petegaggs/DOMS-mini-synth/README.md

# DOMS-mini-synth
An arduino controlled mini-synth with MIDI input, AS3394E main voice, AS3340 2nd oscillator
