petegaggs/DOMS-mini-synth/DOMS_SYNTH_BOM_2.1.xlsx

Sheet: Main Board Parts
Description | Designator | Footprint | Quantity | Manufacturer Part | Manufacturer | Supplier | Supplier Part
DOMS synth
Rev 2.1
Bill of materials
Main board parts
Semiconductors
ATMEGA328P-PU | U1 | DIP-28_300MIL | 1 | ATMEGA328P-PU | ATMEL
IC 6N139 Opto Isolator | U2 | DIP-8 | 1 | 6N139M | FAIRCHILD
Diode 1N4148 | D1,D3,D4,D6,D7 | DO-35 | 5
Diode 1N4004 | D2,D5 | DO-41 | 2
IC Voltage Controlled Oscillator Alfa AS3340 | U16 | DIP-16 | 1 | AS3340 | Alfa Rpar | Soundtronics | 7212-591
IC uP controllable synthesizer voice AS3394E | U6 | DIP-24 | 1 | AS3394E | Alfa Rpar | Soundtronics | 7212-594
Adjustable Precision shunt regulator 1% TL431ACLP | U10 | TO-92 | 1 | TL431ACLP | TI
IC 12-bit dual SPI DAC MCP4822-E/P | U4 | DIP-8 | 1 | MCP4822-E/P | Microchip | Digi-Key | MCP4822-E/P-ND
IC Voltage regulator positive adjustable TO-220 1.5A LM317T | U5,U3,U22 | TO-220-3 | 3 | LM317T/NOPB | TI | Digi-key | LM317TNS/NOPB-ND
IC Voltage regulator negative adjustable TO-220 1.5A LM337T | U7,U11 | TO-220-3 | 2 | LM337T/NOPB | TI | Digi-key | LM337TNS/NOPB-ND
IC Quad Op amp LM324N DIP-14 | U13,U12,U9,U14,U8 | PDIP-14 | 5 | LM324N/NOPB | TI
Resistors
Resistor Metal Film 1/4W 1% 100R | R40 | AXIAL-0.4 | 1
Resistor Metal Film 1/4W 1% 220R | R83 | AXIAL-0.4 | 1
Resistor Metal Film 1/4W 1% 100R | R40 | AXIAL-0.4 | 1
Resistor Metal Film 1/4W 1% 470R | R55,R60 | AXIAL-0.4 | 2
Resistor Metal Film 1/4W 1% 510R | R42 | AXIAL-0.4 | 1
Resistor Metal Film 1/4W 1% 560R | R77,R79 | AXIAL-0.4 | 2
Resistor Metal Film 1/4W 1% 820R | R9 | AXIAL-0.4 | 1
Resistor Metal Film 1/4W 1% 1K | R63,R82,R73 | AXIAL-0.4 | 3
Resistor Metal Film 1/4W 1% 1K8 | R56 | AXIAL-0.4 | 1
Resistor Metal Film 1/4W 1% 3K | R81,R76 | AXIAL-0.4 | 2
Resistor Metal Film 1/4W 1% 3K3 | R8 | AXIAL-0.4 | 1
Resistor Metal Film 1/4W 1% 4K7 | R7,R78,R80 | AXIAL-0.4 | 3
Resistor Metal Film 1/4W 1% 5K6 | R43 | AXIAL-0.4 | 1
Resistor Metal Film 1/4W 1% 10K | R46,R47,R48,R53,R64,R71,R1,R11,R39,R70 | AXIAL-0.4 | 10
Resistor Metal Film 1/4W 1% 15K | R50,R51 | AXIAL-0.4 | 2
Resistor Metal Film 1/4W 1% 18K | R22 | AXIAL-0.4 | 1
Resistor Metal Film 1/4W 1% 20K | R26,R27,R44 | AXIAL-0.4 | 3
Resistor Metal Film 1/4W 1% 24K | R41,R10 | AXIAL-0.4 | 2
Resistor Metal Film 1/4W 1% 30K | R49,R52 | AXIAL-0.4 | 2
Resistor Metal Film 1/4W 1% 33K | R21 | AXIAL-0.4 | 1
Resistor Metal Film 1/4W 1% 47K | R36,R37,R72 | AXIAL-0.4 | 3
Resistor Metal Film 1/4W 1% 51K | R57,R62 | AXIAL-0.4 | 2
Resistor Metal Film 1/4W 1% 56K | R61 | AXIAL-0.4 | 1
Resistor Metal Film 1/4W 1% 62K | R15,R16 | AXIAL-0.4 | 2
Resistor Metal Film 1/4W 1% 68K | R65,R6 | AXIAL-0.4 | 2
Resistor Metal Film 1/4W 1% 75K | R4 | AXIAL-0.4 | 1
Resistor Metal Film 1/4W 1% 82K | R28 | AXIAL-0.4 | 1
Resistor Metal Film 1/4W 1% 100K | R59,R38,R69,R75,R23,R29,R30,R13,R17,R18,R32,R33,R12 | AXIAL-0.4 | 13
Resistor Metal Film 1/4W 1% 130K | R3 | AXIAL-0.4 | 1
Resistor Metal Film 1/4W 1% 150K | R66,R19,R20,R31 | AXIAL-0.4 | 4
Resistor Metal Film 1/4W 1% 180K | R68 | AXIAL-0.4 | 1
Resistor Metal Film 1/4W 1% 240K | R35,R67,R5 | AXIAL-0.4 | 3
Resistor Metal Film 1/4W 1% 270K | R34 | AXIAL-0.4 | 1
Resistor Metal Film 1/4W 1% 300K | R58 | AXIAL-0.4 | 1
Resistor Metal Film 1/4W 1% 330K | R24,R14 | AXIAL-0.4 | 2
Resistor Metal Film 1/4W 1% 1M | R45,R54,R74,R25 | AXIAL-0.4 | 4
Capacitors
Capacitor ceramic 22pF 50V NPO 10% | C1,C2 | RAD-0.1 | 2
Capacitor Ceramic NPO 50V 5% 5mm 150pF | C55 | CAP-TH_L5.0 | 1
Capacitor multilayer ceramic 50V 10% 560p | C38 | 4.5MM X 7.2MM | 1 |  |  | Tayda | A-1365
Capacitor Polyester WIMA FKS2 100v 5% 1nF | C29,C46 | 4.5MM X 7.2MM | 2 | FKS2D011001A00JSSD | WIMA | Tayda | A-1531
Capacitor Polyester 100V 5% 1.5nF | C54 | CAP-TH_L5.0 | 1 |  |  | Soundtronics | 7212-778
Capacitor Polyester WIMA FKS2 100v 5% 2.2nF | C30,C33 | 4.5MM X 7.2MM | 2 | FKS2D012201A00JSSD | WIMA | Tayda | A-935
Capacitor Ceramic NPO 50V 5% 5n6 | C31 | CAP-TH_L5.0-W2.5-P5.08-D0.7 | 1 | C320C104K5R5TA7303 | KEMET | LCSC | C236029
Capacitor Ceramic radial X7R 50V 10% 10nF | C47,C49,C50,C56,C53 | CAP-TH_L5.0 | 5 |  |  | Soundtronics | 7212-746
Capacitor Ceramic radial X7R 50V 10% 15nF | C51,C52 | CAP-TH_L5.0 | 2 |  |  | Soundtronics | 2069-066
Capaictor Polyester WIMA MKS2 100V 5% 33nF | C35,C36,C37 | 4.5MM X 7.2MM | 3 | MKS2D023301A00JSSD | WIMA | Tayda | A-4172
Capacitor Ceramic radial X7R 50V 10% 100nF | C10,C44,C45,C48,C41,C42,C27,C28,C32,C34,C3,C4,C5,C12,C11,C21,C23,C24,C22,C26,C14,C16,C17,C19,C20,C9,C57,C58,C59,C60 | CAP-TH_L5.0 | 30 |  |  | Tayda | A-214
Capacitor Electrolytic Non-Polar 4.7uF 50V 5x11 | C43 | CAP-5*11 | 1 |  |  | Soundtronics | 7213-310
Capacitor Electrolytic 100uF 16V 85 degree 6.3x11 | C15,C7,C25,C13,C18 | CAP-TH_D0.7-L6.3-H7-PITCH2.5 | 5
Capacitor Electrolytic 4700uF 20% 25V 16x26mm | C8,C6 | CAP-D18.0XF7.5 | 2
Crystals
Crystal HC-49 16.000MHz low profile | Y1 | HC49US | 1
Connectors
Header Male 0.1” pitch single row 2 way | P1 |  | 1
Header Male 0.1” pitch single row 6 way | P4 |  | 1
Switches
Miniature Toggle Switch SPDT ON/ON | S1,S4,S3 | SWITCH_TOGGLE_SPDT | 3 |  |  | Soundtronics | 7212-250
Miniature Toggle Switch SPDT ON/OFF/ON | S2 | SWITCH_TOGGLE_SPDT | 1 |  |  | Soundtronics | 7212-250
Potentiometers
POT 9mm PCB Mount 100K Linear | VR15,VR11,VR12,VR4,VR7,VR8,VR9,VR16,VR17,VR18,VR19,VR3,VR5,VR6,VR10 | POT-VERT-9MM | 15 | None |  | Soundtronics | 7300-785
Trimmer POT 25 turns 3296W 10K 10 % | VR13,VR1 | TRIMPOT 3 POLE | 2 | 3296W-1-103LF | Bourns | Soundtronics | 7212-857
Trimmer POT 25 turns 3296W 20K 10 % | VR14,VR2 | TRIMPOT 3 POLE | 2 | 3296W-1-203LF | Bourns | Soundtronics | 7212-858

Sheet: Other parts
DOMS synth
Rev 2.0
Bill of materials
Other parts
Description | Function | Quantity
DC Power Jack 2.1mm Panel Mount Bulkhead | Power in AC12V | 1
Knobs | for pots | 14
5-Pin DIN Socket, panel mount | MIDI in | 1
6.35mm 1/4" Mono Chassis Socket | Audio out | 1
Case |  | 1
Aluminium panel 200mm x 150mm x 1.5mm thickness |  | 1
