petegaggs/DOMS-mini-synth/DOMS schematic rev2.1.pdf

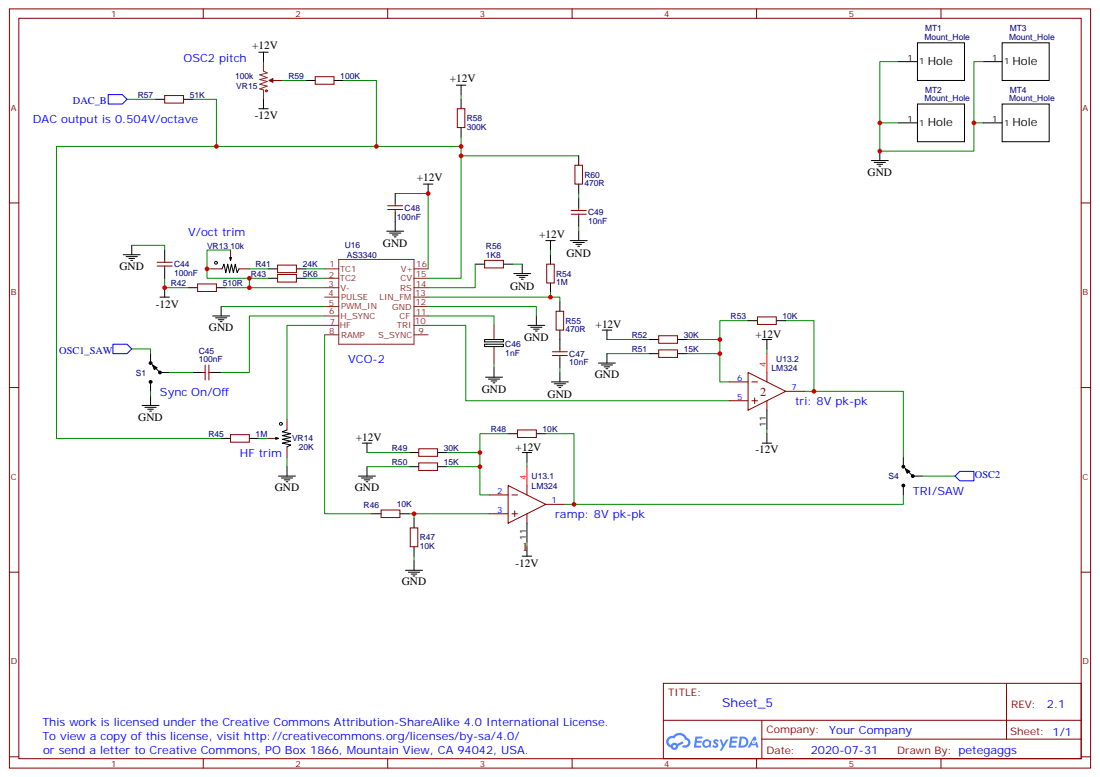
[picture p1: page 1]

DAC output is 0.504V/octave

This work is licensed under the Creative Commons Attribution-ShareAlike 4.0 International License.
To view a copy of this license, visit http://creativecommons.org/licenses/by-sa/4.0/
or send a letter to Creative Commons, PO Box 1866, Mountain View, CA 94042, USA.

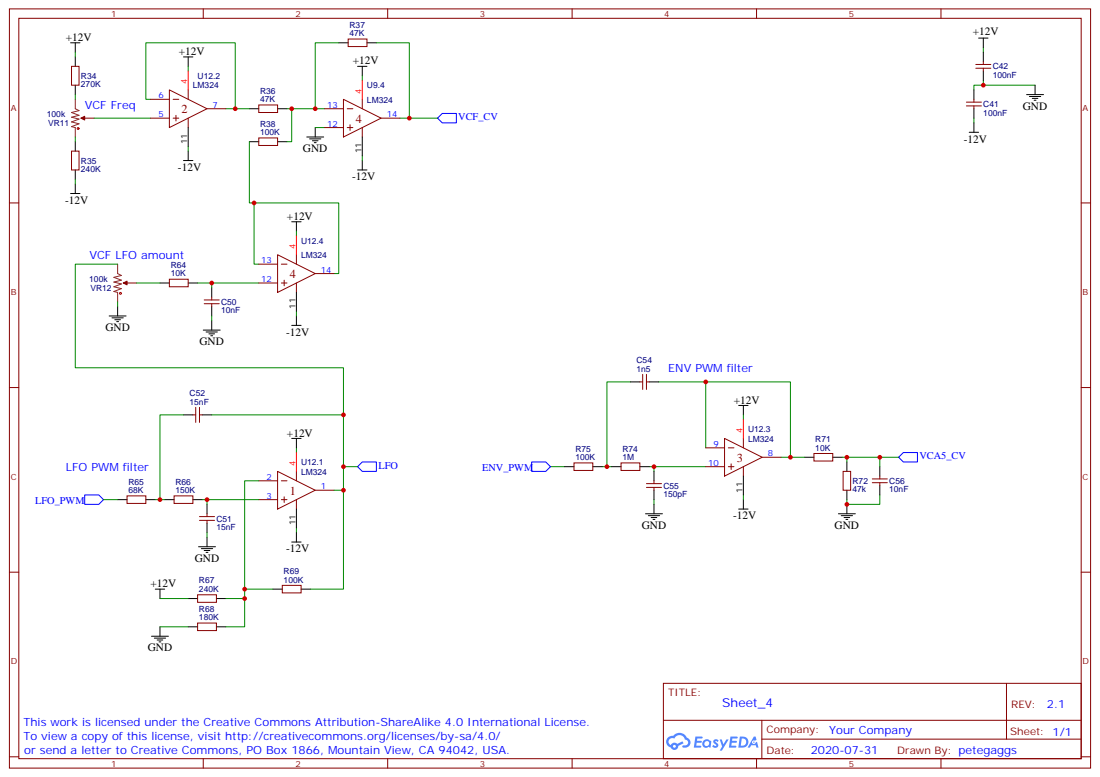
[picture p2: page 2]

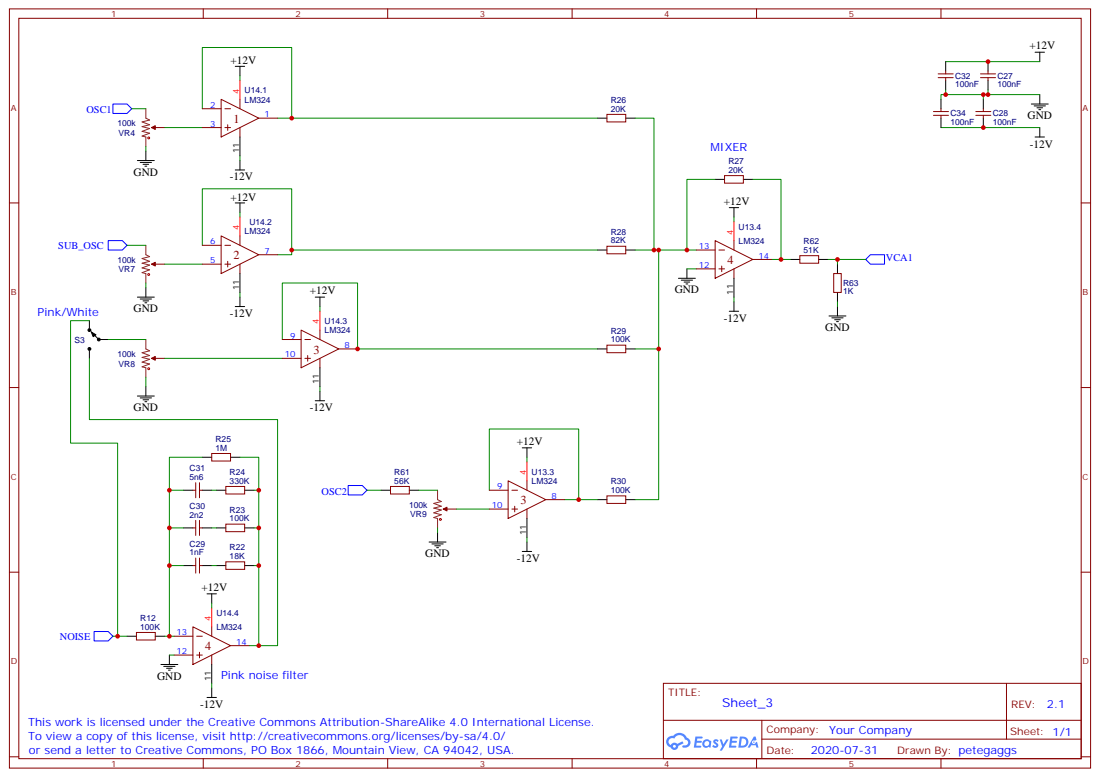
[picture p3: page 3]

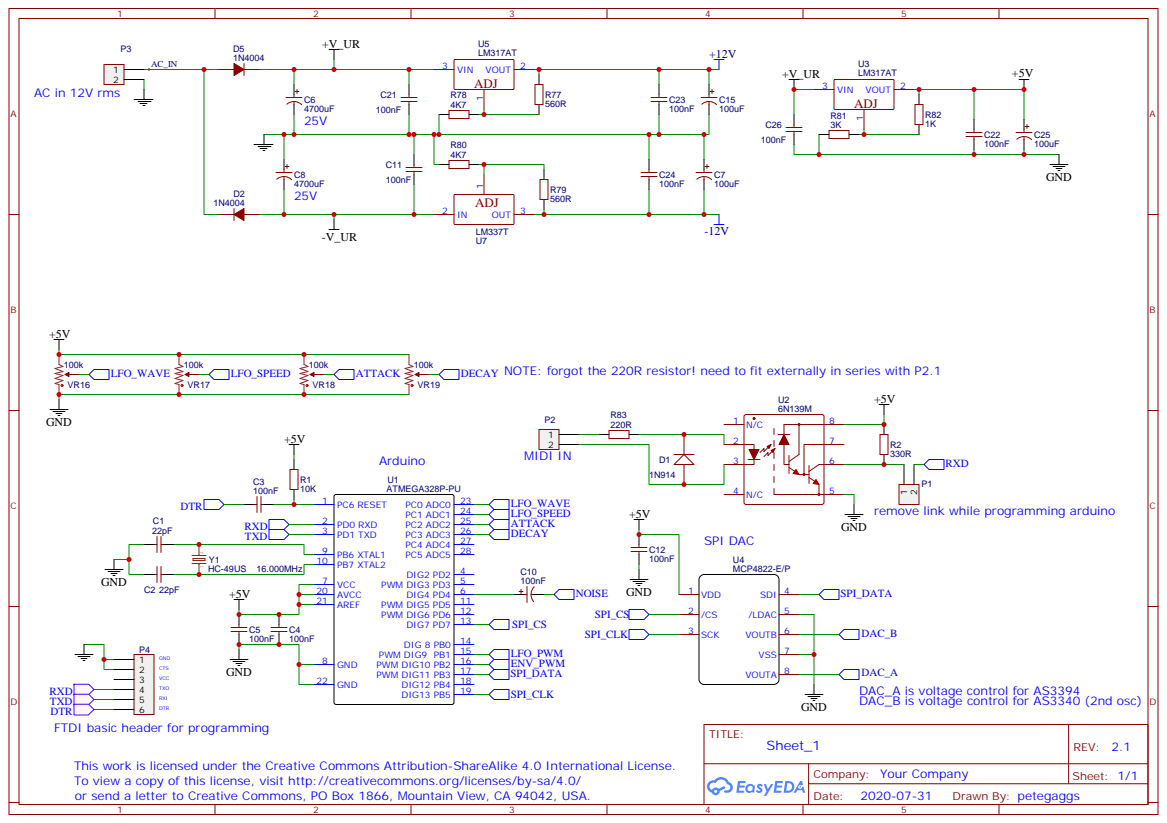
[picture p4: page 4]

NOTE: forgot the 220R resistor! need to fit externally in series with P2.1

remove link while programming arduino
GND

DAC_A
DAC_A is voltage control for AS3394
DAC_B is voltage control for AS3340 (2nd osc)

RXD
TXD
DTR
FTDI basic header for programming

Company: Your Company To view a copy of this license, visit http://creativecommons.org/licenses/by-sa/4.0/

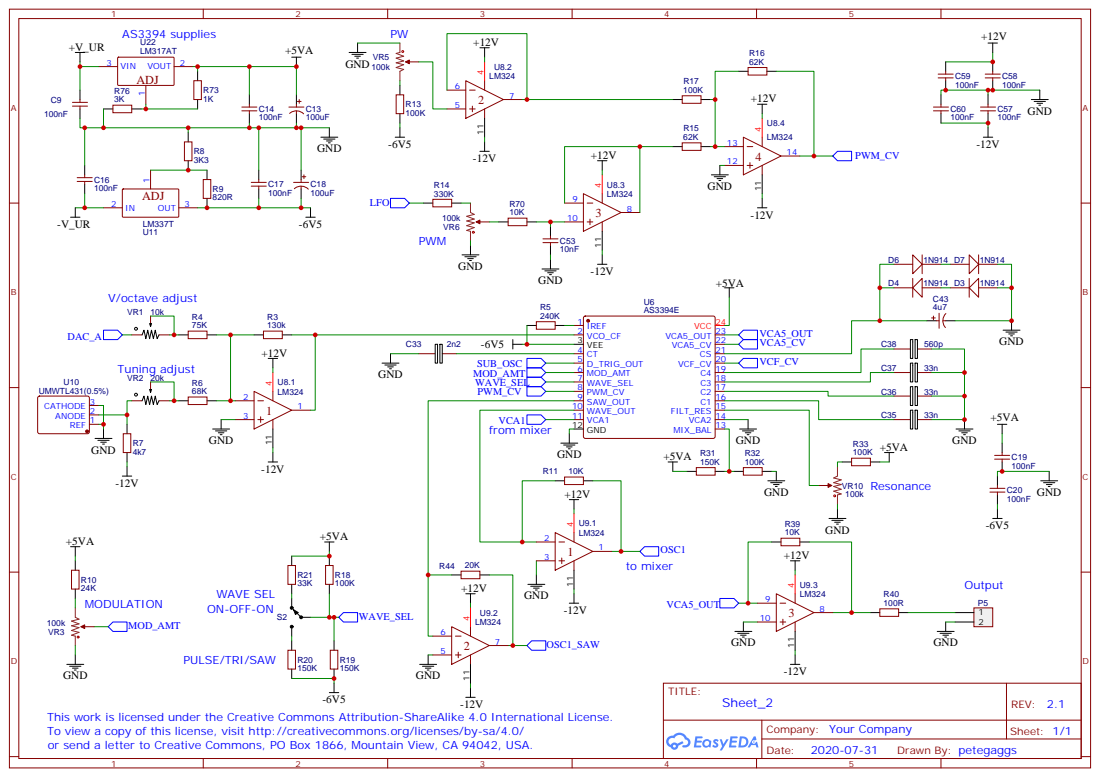
[picture p5: page 5]
