petegaggs/DOMS-mini-synth/(commit log)

2020-07-26 Add files via upload
    initial code, just SPI DAC control for now
2020-07-27 Add files via upload
    added timer interrupt and noise
    [DOMS_SYNTH.ino]
2020-08-23 Add files via upload
    Add extra LFO waveforms:
    sweep up (like an envelope)
    sweep down (like an envelope)
    sample and hold
    change control of LFO rate from logarithmic to linear
2020-08-30 Add files via upload
    change R15-16 to 62k
    [DOMS_SYNTH_BOM_2.1.xlsx]
2020-08-30 Delete DOMS schematic rev2.0.pdf
    obsolete
2020-08-30 Delete DOMS_SYNTH_BOM_2.xlsx
    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
    [DOMS_SYNTH_BOM_2.xlsx]
2021-12-31 added midi pitch bend
