petegaggs/DOMS-mini-synth/(notices)

Notices in the files:
DOMS_SYNTH.ino:
MIT License
Copyright (c) 2019 petegaggs
